zzl0lzz/Final-Year-Project/README.md

# Final-Year-Project-
BSAS (Bicycle Safety Assistance System)
